kotoole1/LooneyTunes/README.md

Pitches
=======
(ain't shit)

POE Project repository
