kotoole1/LooneyTunes/DocumentationWebsite/static/PDFs/CriticalDesignReview.pdf

# Looney Tunes

Preliminary Review
Allie, Chris, Kevin, Kyle, Philicia

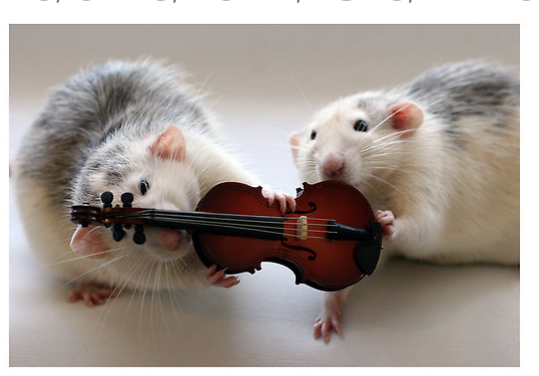
[picture p1: figure]

Things we’ve done...

- Transition from 1 string to 4 strings
- Addition of a bow wheel
- Addition of “string pulling” system
- Addition of an amplifier
- Human interaction via Beagle Bone

### Mechanical Design Changes

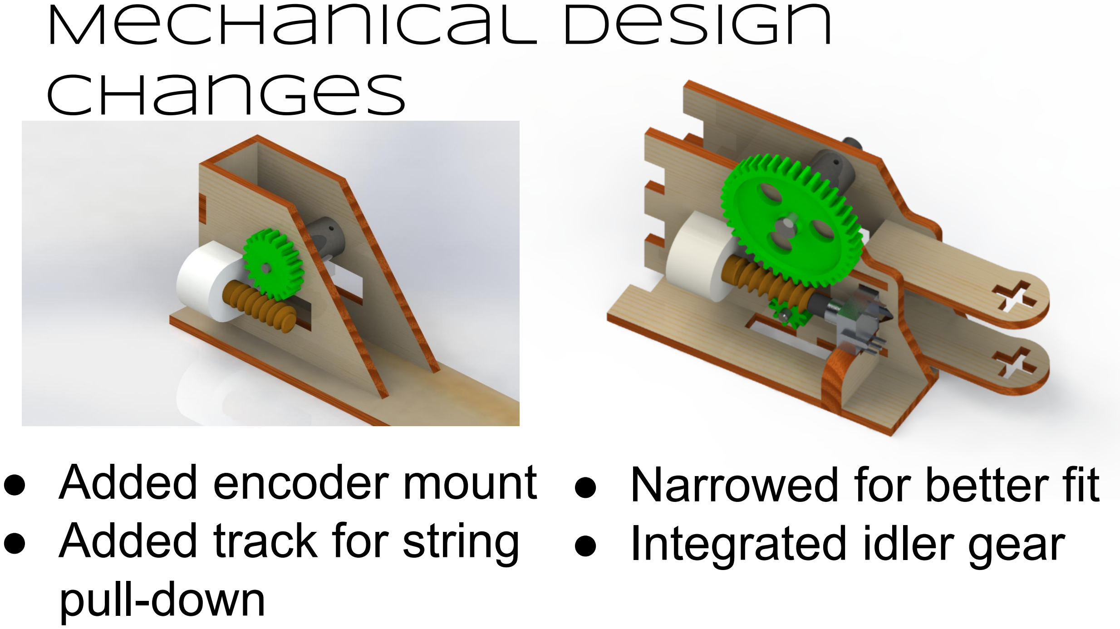
[picture p2: page 3]

- Added encoder mount
- Added track for string
pull-down
- Narrowed for better fit
- Integrated idler gear

### Electrical Design

- Integrated pickup
- Added filter to kill 60Hz noise
- Integrated H-Bridge motor control

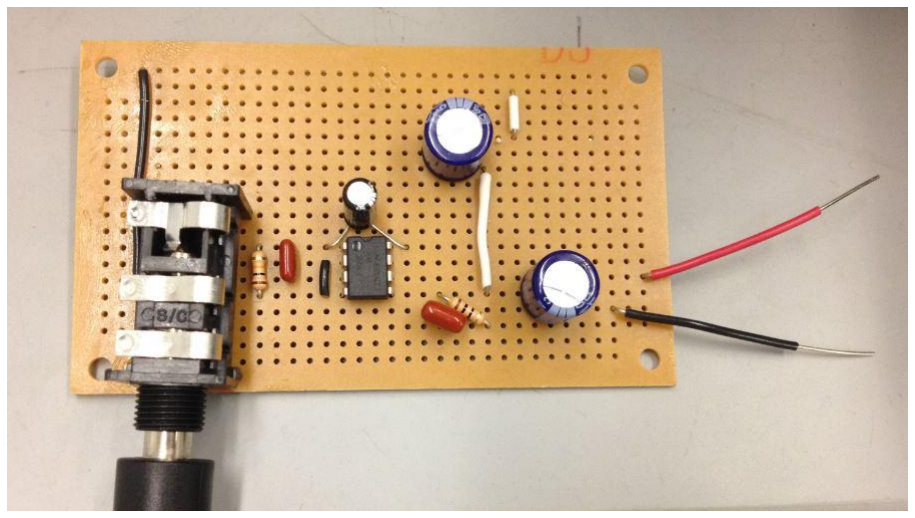
[picture p3: figure]

### Software Design

- Got Beagle Bone working!

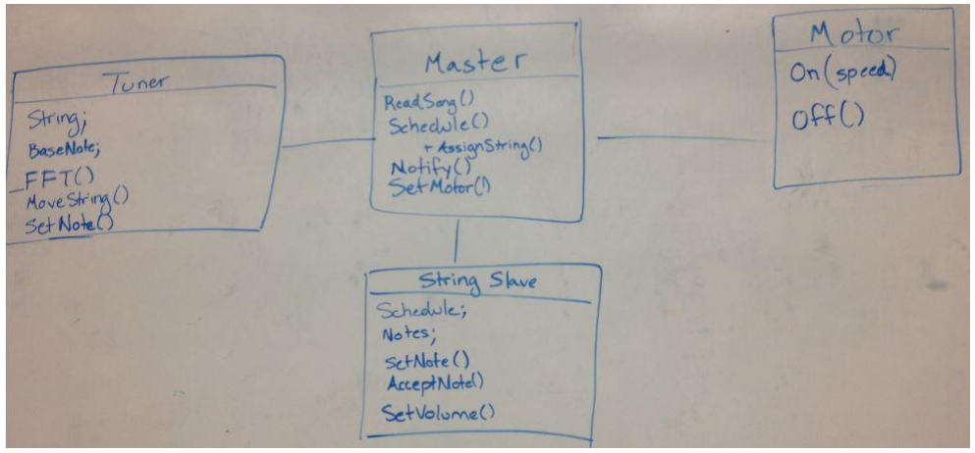
[picture p4: figure]

### Things to work on…

- Stiffness of bridge and far panel
- Rollers for “string pulling” system
- Attachment of bow hair
- Bow’s motor
- Making it pretty!

# Questions?

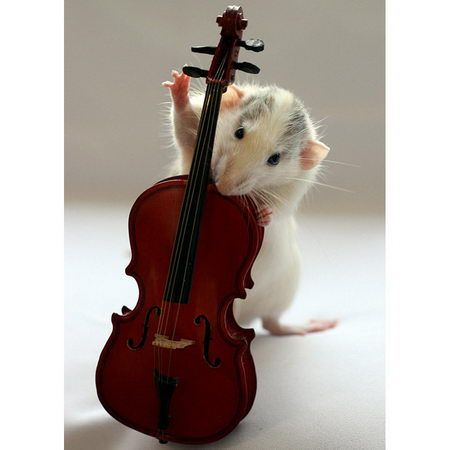
[picture p5: figure]
