kotoole1/LooneyTunes/DocumentationWebsite/static/PDFs/PreliminaryReviewPowerPoint.pdf

# Looney Tunes

# Preliminary Review

## Allie, Chris, Kevin, Kyle, Philicia

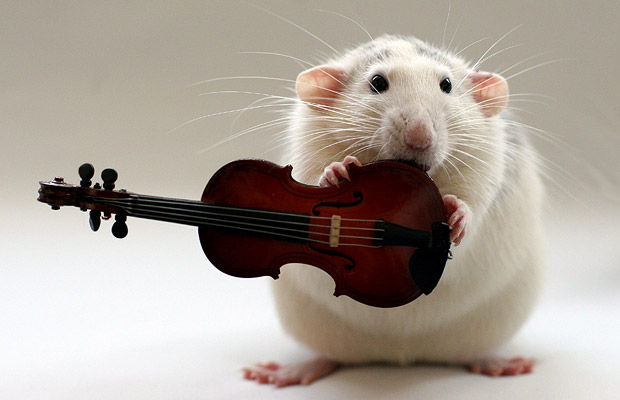
[picture p6: figure]

# Goals & Design Metrics

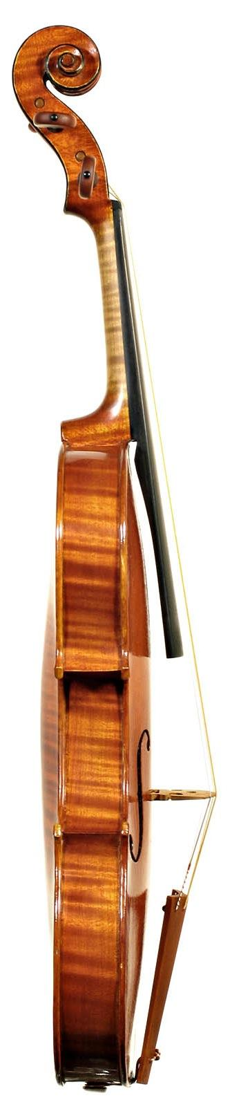
[picture p7: figure]

# 1. Create a string instrument that is controlled and played mechanically 2. Capable of playing music that a traditional violin cannot (e.g. chords, large interval

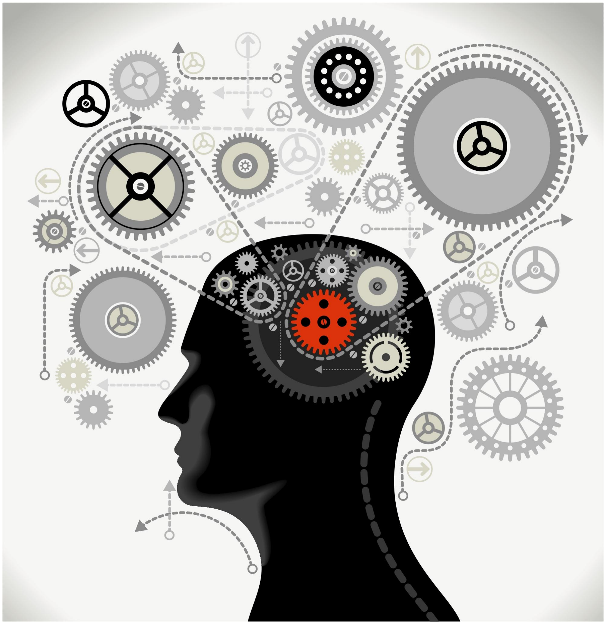
[picture p8: figure]

# gaps) 3. Connect to an engaging interface for the listener to choose songs

# System Diagram

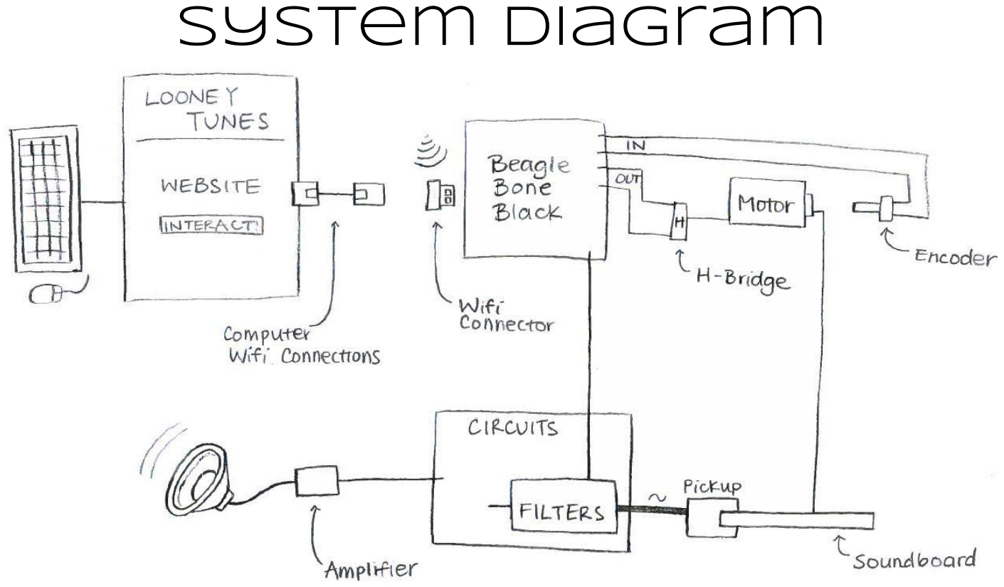
[picture p9: page 3]

# Rough mechanical design

# Block CAD

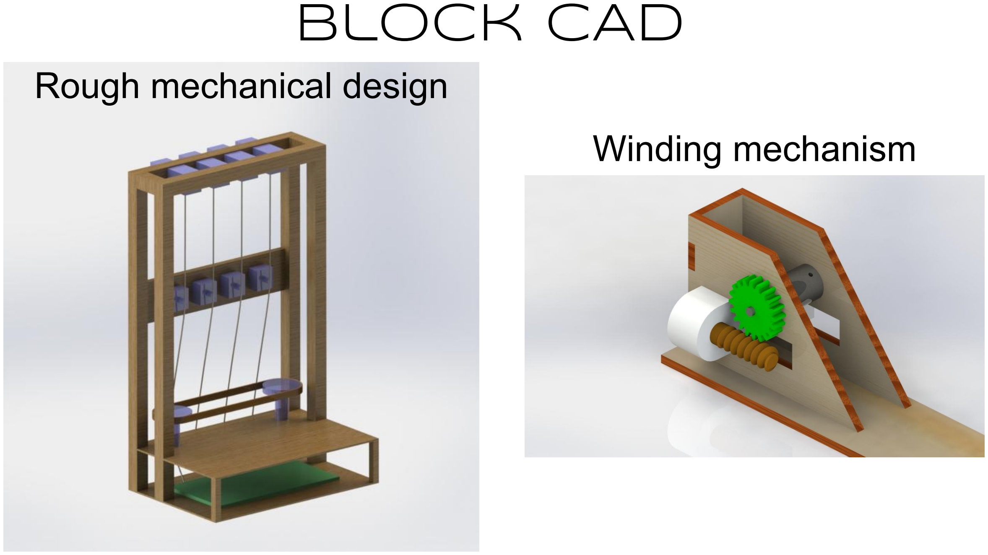
[picture p10: page 4]

# Winding mechanism

# Electrical Subsystem

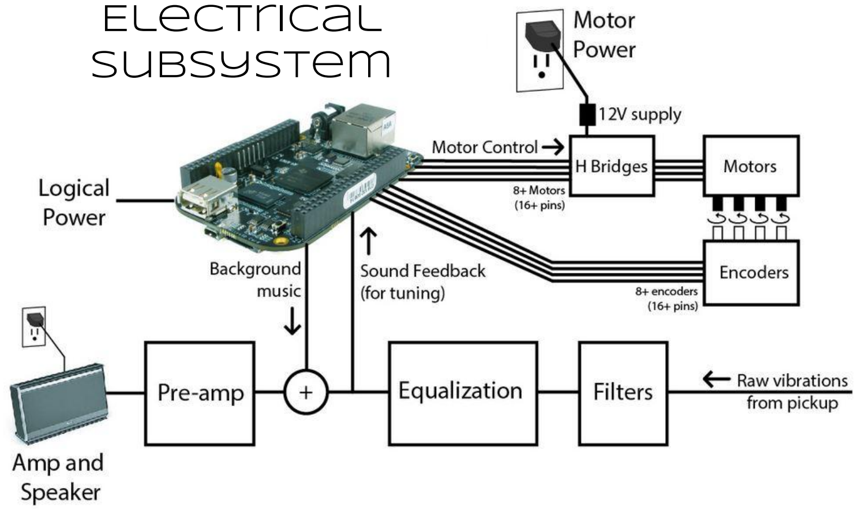
[picture p11: page 5]

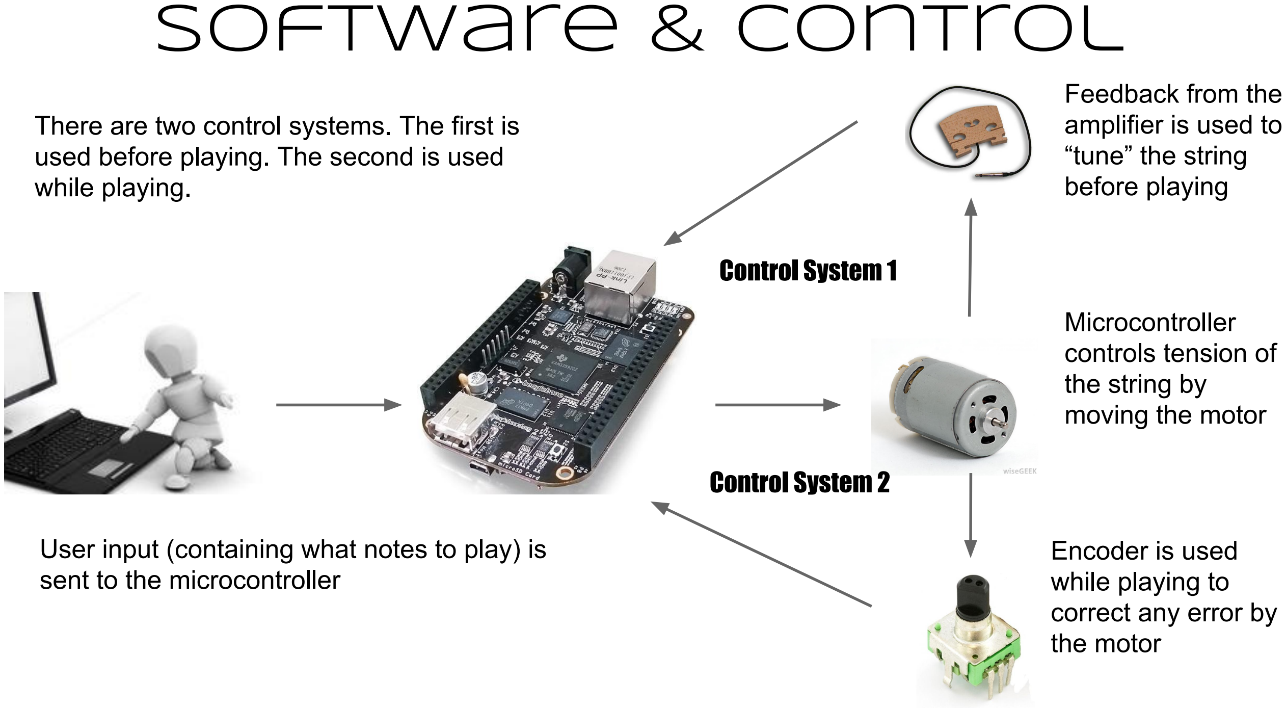
[picture p12: figure]
Software & Control; Microcontroller controls tension of the string by moving the motor; Feedback from the amplifier is used to “tune” the string before playing; Encoder is used while playing to correct any error by the motor; sent to the microcontroller; Control System 1; Control System 2; used before playing. The second is used while playing.

User input (containing what notes to play) is

There are two control systems. The first is

# Critical Milestones & Deadlines

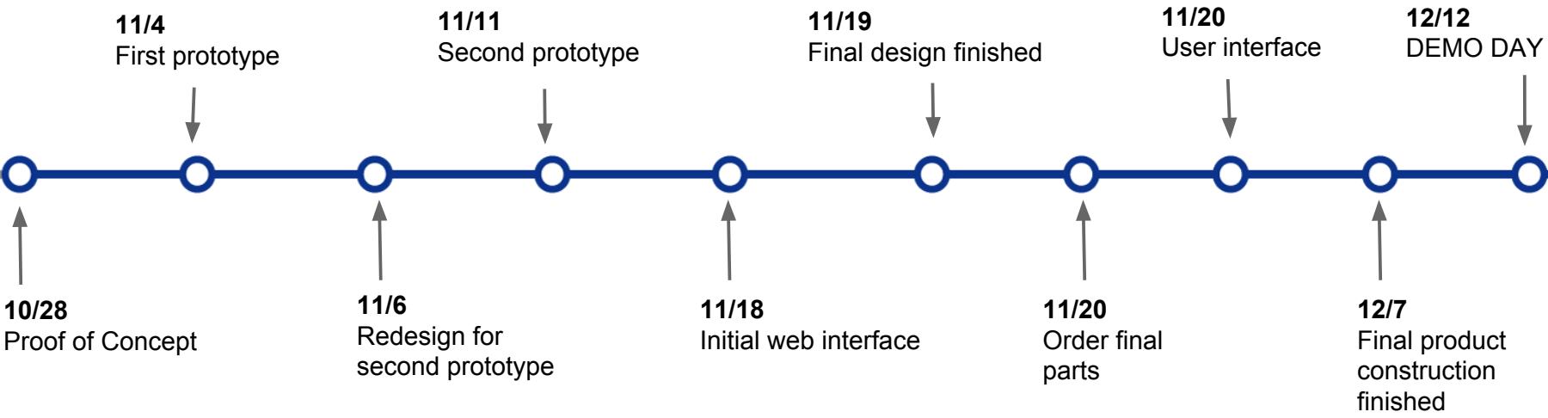
[picture p13: figure]
10/28 Proof of Concept; 11/4 First prototype; 11/6 Redesign for second prototype; 11/11 Second prototype; 11/18 Initial web interface; 11/20 Order final parts; 12/12 DEMO DAY; 12/7 Final product construction finished; 11/19 Final design finished; 11/20 User interface

# Proof of concept

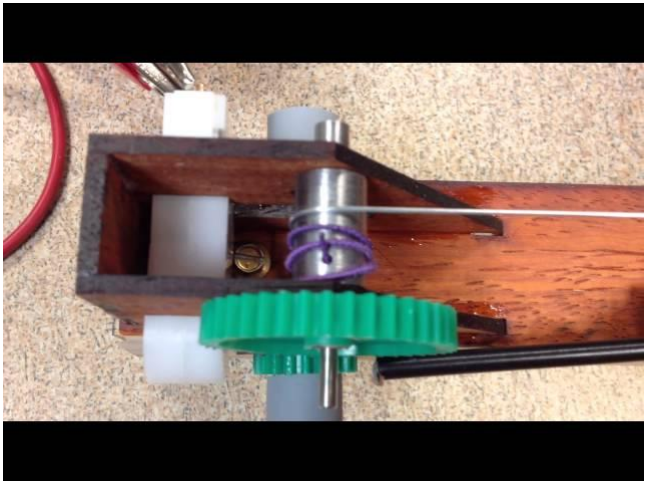
[picture p14: figure]

# Proof of Concept

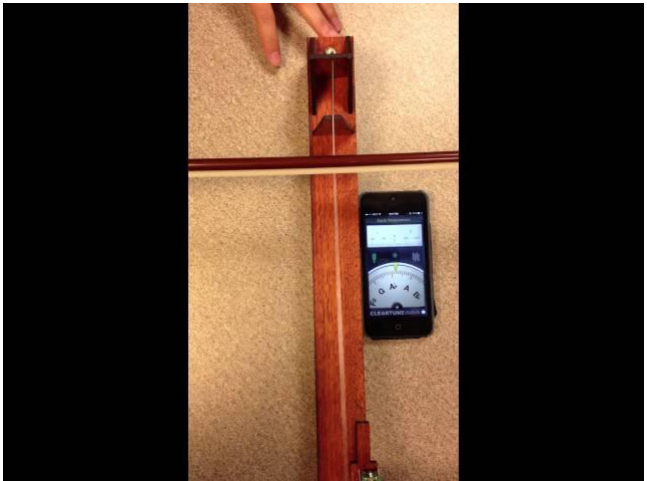
[picture p15: figure]

# Questions?

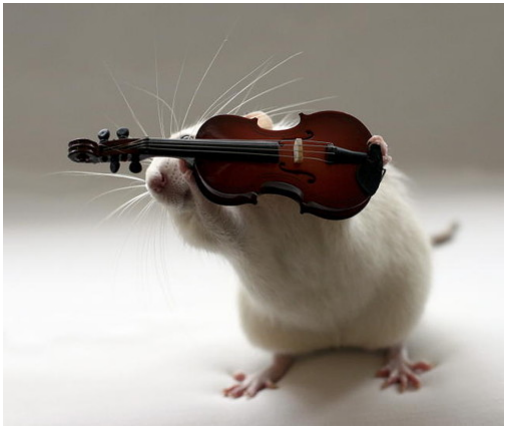
[picture p16: figure]
