kotoole1/LooneyTunes/DocumentationWebsite/static/PDFs/LT3-schematic.pdf

# Electrical Overview

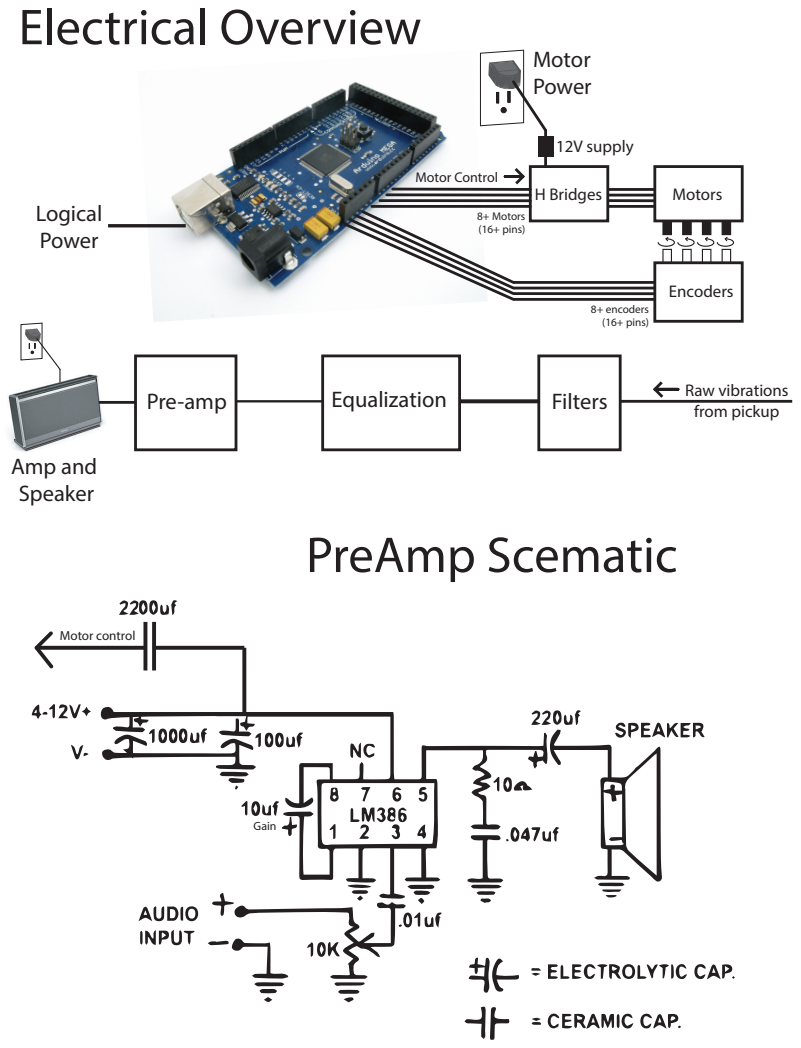
[picture p17: page 1]
Pre-amp; Filters; Amp and Speaker; Raw vibrations; Logical Power; H Bridges; Motor Power; 12V supply; Motors; Encoders; Motor Control; 8+ Motors (16+ pins); 8+ encoders (16+ pins); Gain; Motor control; PreAmp Scematic

from pickup Equalization

5V Logical Power

12V Motor Power | 5V (EN HIGH)

5V (EN HIGH)

L293D

Motor 1
INPUT 1

Motor 2
INPUT 2

Motor 1
INPUT 2

Motor 2
INPUT 1

GND

GND | GND
| GND

Motor 1
OUTPUT HIGH

Motor 1
OUTPUT LOW | Motor 2
| OUTPUT LOW

Motor 2
Output HIGH

# H-Bridge Connections
