kotoole1/LooneyTunes/DocumentationWebsite/static/PDFs/LT3-DrawingPackage.pdf

12 | 7 | 23 | 9 | 10 | 8 | 13 | 6 | 24 | 11

1

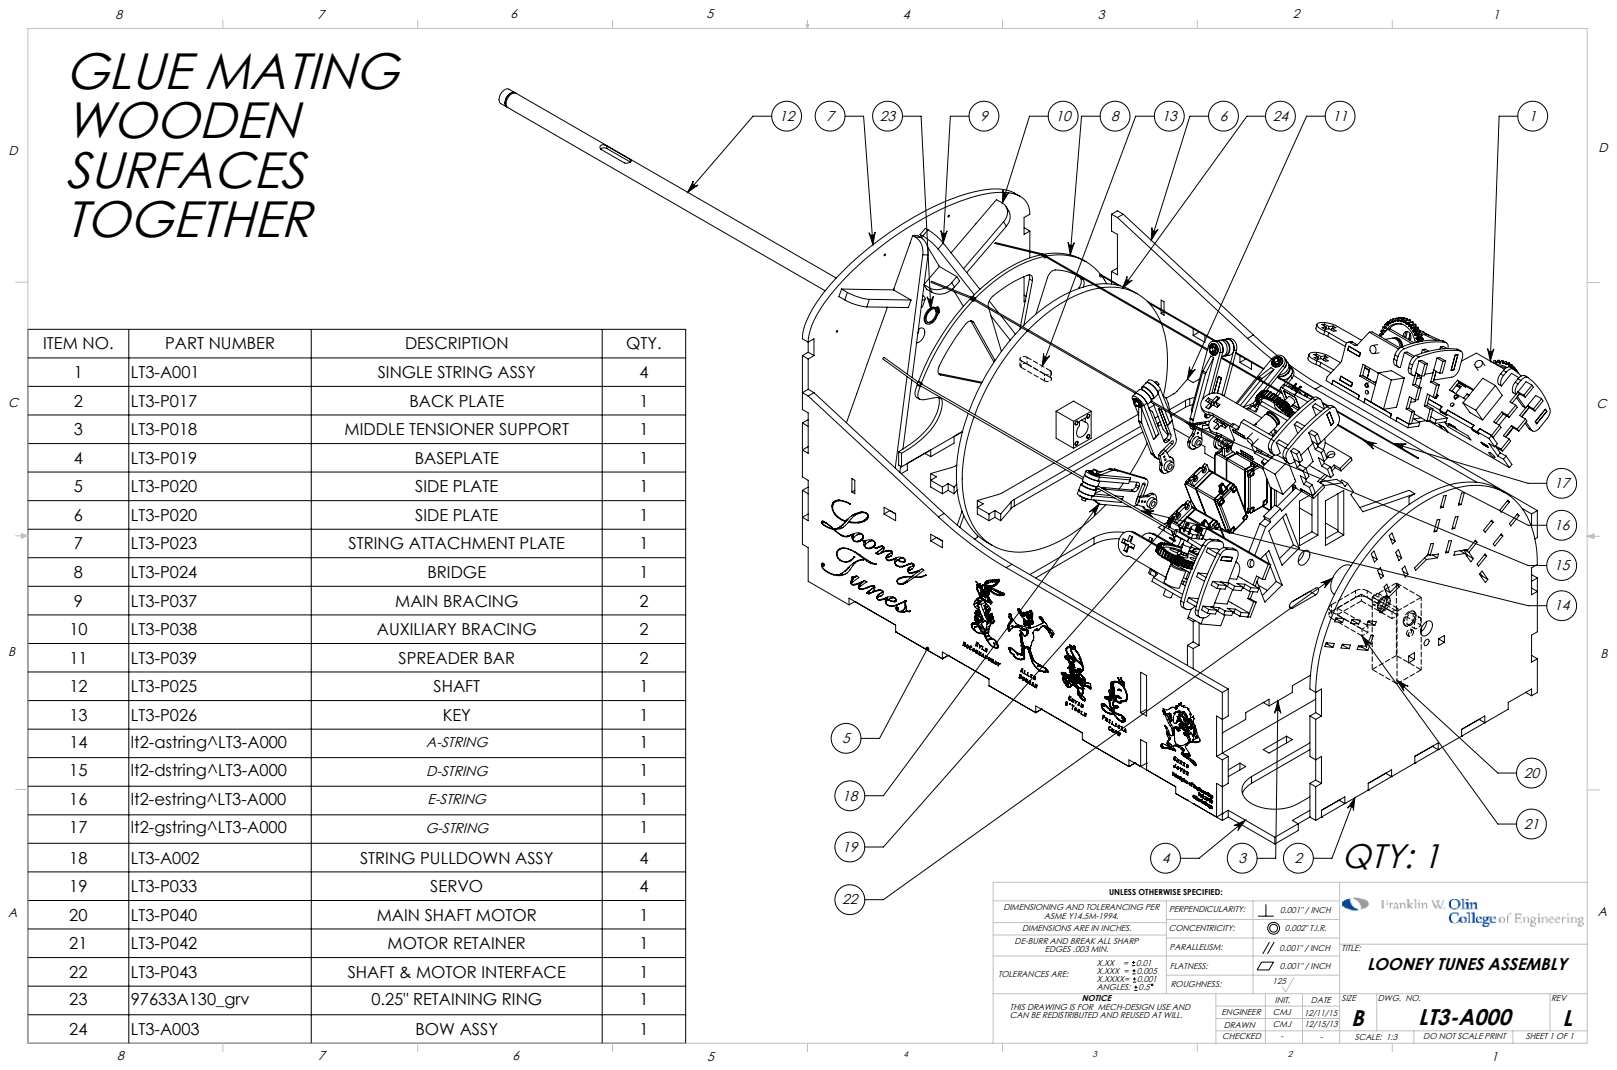
[picture p18: page 1]
GLUE MATING WOODEN SURFACES TOGETHER; QTY: 1

ITEM NO. | PART NUMBER | DESCRIPTION | QTY.
1 | LT3-A001 | SINGLE STRING ASSY | 4
2 | LT3-P017 | BACK PLATE | 1
3 | LT3-P018 | MIDDLE TENSIONER SUPPORT | 1
4 | LT3-P019 | BASEPLATE | 1
5 | LT3-P020 | SIDE PLATE | 1
6 | LT3-P020 | SIDE PLATE | 1
7 | LT3-P023 | STRING ATTACHMENT PLATE | 1
8 | LT3-P024 | BRIDGE | 1
9 | LT3-P037 | MAIN BRACING | 2
10 | LT3-P038 | AUXILIARY BRACING | 2
11 | LT3-P039 | SPREADER BAR | 2
12 | LT3-P025 | SHAFT | 1
13 | LT3-P026 | KEY | 1
14 | lt2-astring^LT3-A000 | A-STRING | 1
15 | lt2-dstring^LT3-A000 | D-STRING | 1
16 | lt2-estring^LT3-A000 | E-STRING | 1
17 | lt2-gstring^LT3-A000 | G-STRING | 1
18 | LT3-A002 | STRING PULLDOWN ASSY | 4
19 | LT3-P033 | SERVO | 4
20 | LT3-P040 | MAIN SHAFT MOTOR | 1
21 | LT3-P042 | MOTOR RETAINER | 1
22 | LT3-P043 | SHAFT & MOTOR INTERFACE | 1
23 | 97633A130_grv | 0.25" RETAINING RING | 1
24 | LT3-A003 | BOW ASSY | 1

UNLESS OTHERWISE SPECIFIED: DIMENSIONING AND TOLERANCING PER PERPENDICULARITY: 0.001" / INCH ASME Y14.5M-1994. DIMENSIONS ARE IN INCHES. CONCENTRICITY: 0.002" T.I.R. DE-BURR AND BREAK ALL SHARP EDGES .003 MIN. PARALLELISM: 0.001" / INCH X.XX = 0.01 FLATNESS: 0.001" / INCH TOLERANCES ARE: X.XXX = 0.005 X.XXXX= 0.001 125 ROUGHNESS: ANGLES: 0.5

TITLE:
LOONEY TUNES ASSEMBLY

NOTICE THIS DRAWING IS FOR MECH-DESIGN USE AND CAN BE REDISTRIBUTED AND REUSED AT WILL. | INIT. DATE 12/15/13 ENGINEER CMJ 12/11/15 DRAWN CMJ CHECKED - | SIZE B | DWG. NO. LT3-A000 | REV L -

SCALE: 1:3 | DO NOT SCALE PRINT | SHEET 1 OF 1

14 | 7
ITEM NO. | PART NUMBER | DESCRIPTION | QTY.

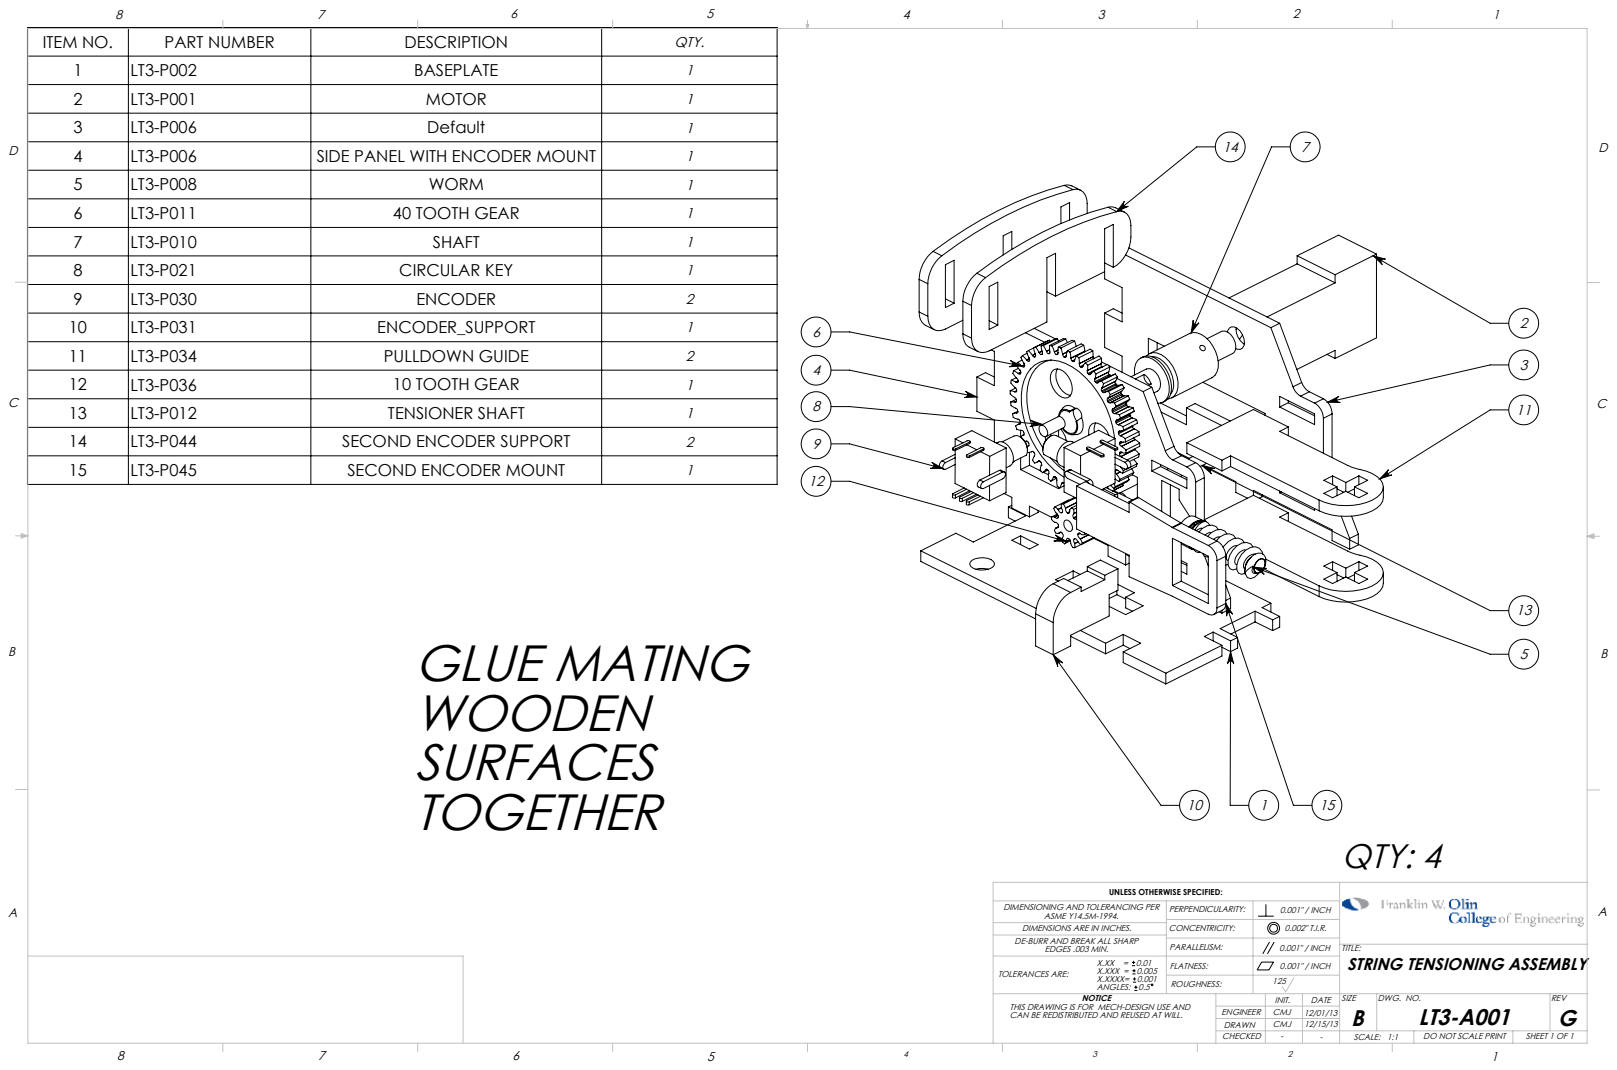
[picture p19: page 2]
GLUE MATING WOODEN SURFACES TOGETHER; QTY: 4

1 | LT3-P002 | BASEPLATE | 1
2 | LT3-P001 | MOTOR | 1
3 | LT3-P006 | Default | 1
4 | LT3-P006 | SIDE PANEL WITH ENCODER MOUNT | 1
5 | LT3-P008 | WORM | 1
6 | LT3-P011 | 40 TOOTH GEAR | 1
7 | LT3-P010 | SHAFT | 1
8 | LT3-P021 | CIRCULAR KEY | 1
9 | LT3-P030 | ENCODER | 2
10 | LT3-P031 | ENCODER_SUPPORT | 1
11 | LT3-P034 | PULLDOWN GUIDE | 2
12 | LT3-P036 | 10 TOOTH GEAR | 1
13 | LT3-P012 | TENSIONER SHAFT | 1
14 | LT3-P044 | SECOND ENCODER SUPPORT | 2
15 | LT3-P045 | SECOND ENCODER MOUNT | 1

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

TITLE:
STRING TENSIONING ASSEMBLY

12/15/13 CMJ 12/01/13 | | LT3-A001 | G -

SCALE: 1:1 | | SHEET 1 OF 1

1

ITEM NO. | PART NUMBER | DESCRIPTION | QTY.

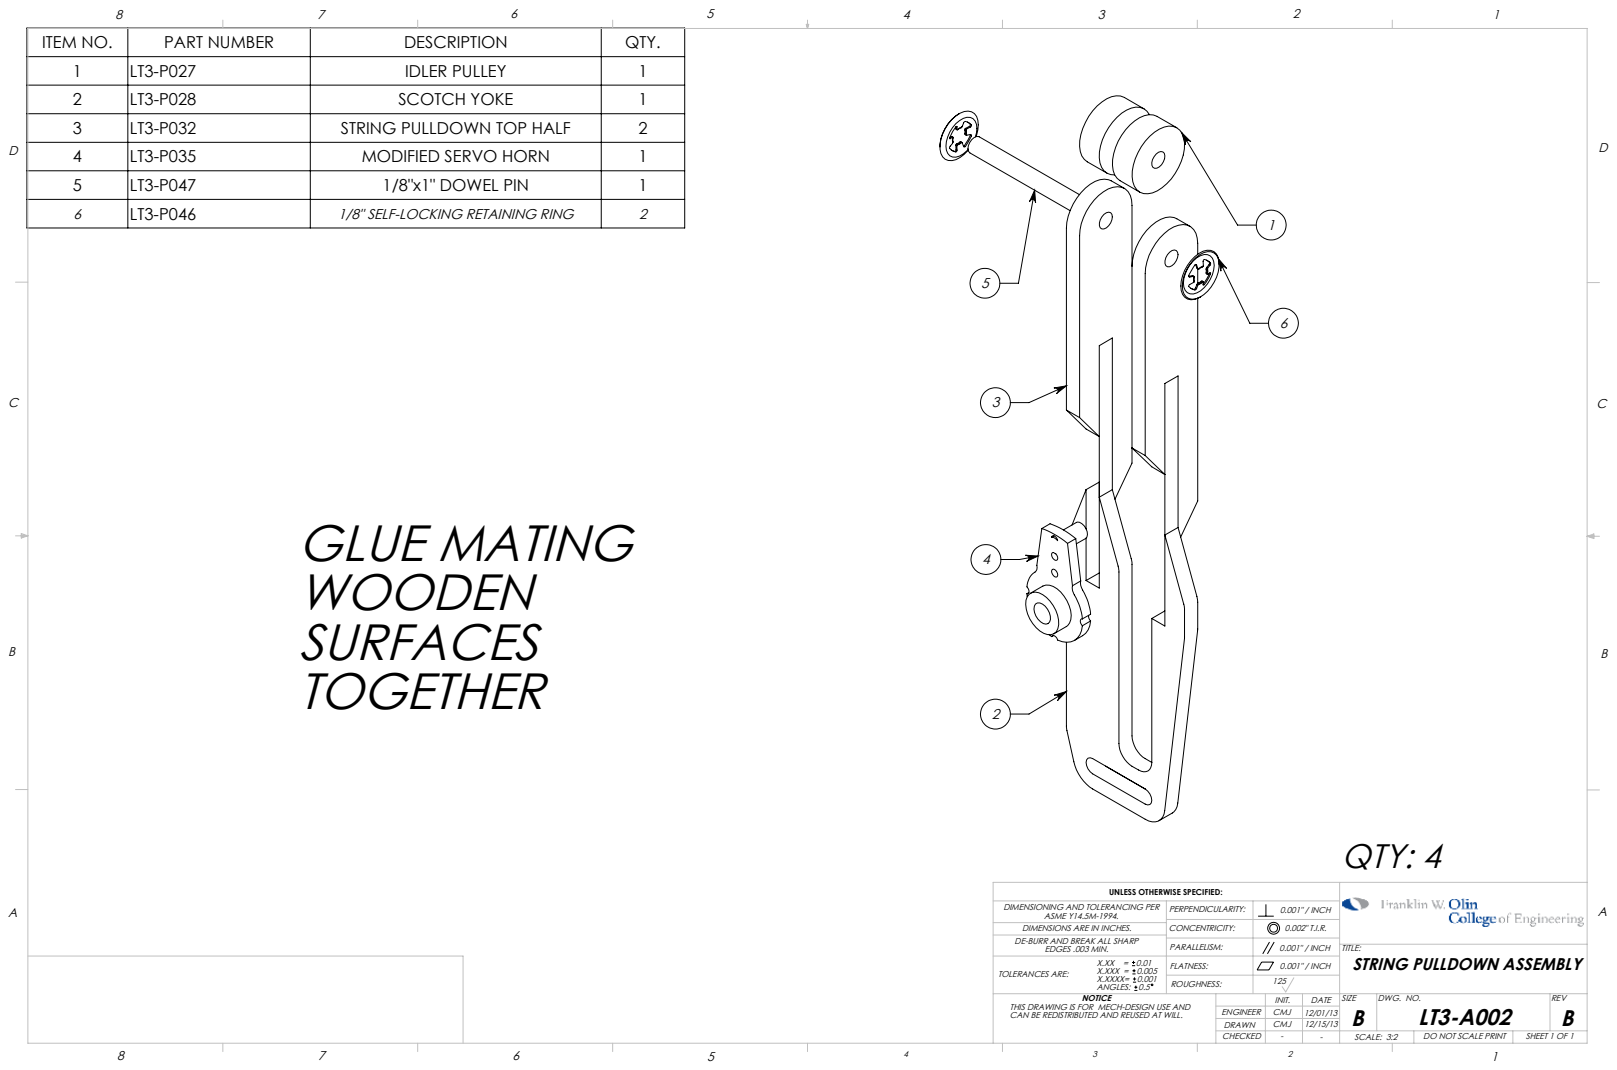
[picture p20: page 3]
GLUE MATING WOODEN SURFACES TOGETHER; QTY: 4

1 | LT3-P027 | IDLER PULLEY | 1
2 | LT3-P028 | SCOTCH YOKE | 1
3 | LT3-P032 | STRING PULLDOWN TOP HALF | 2
4 | LT3-P035 | MODIFIED SERVO HORN | 1
5 | LT3-P047 | 1/8"x1" DOWEL PIN | 1
6 | LT3-P046 | 1/8" SELF-LOCKING RETAINING RING | 2

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

TITLE:
STRING PULLDOWN ASSEMBLY

12/15/13 CMJ 12/01/13 | | LT3-A002 | B -

SCALE: 3:2 | | SHEET 1 OF 1

1

ITEM NO. | PART NUMBER | DESCRIPTION | QTY.

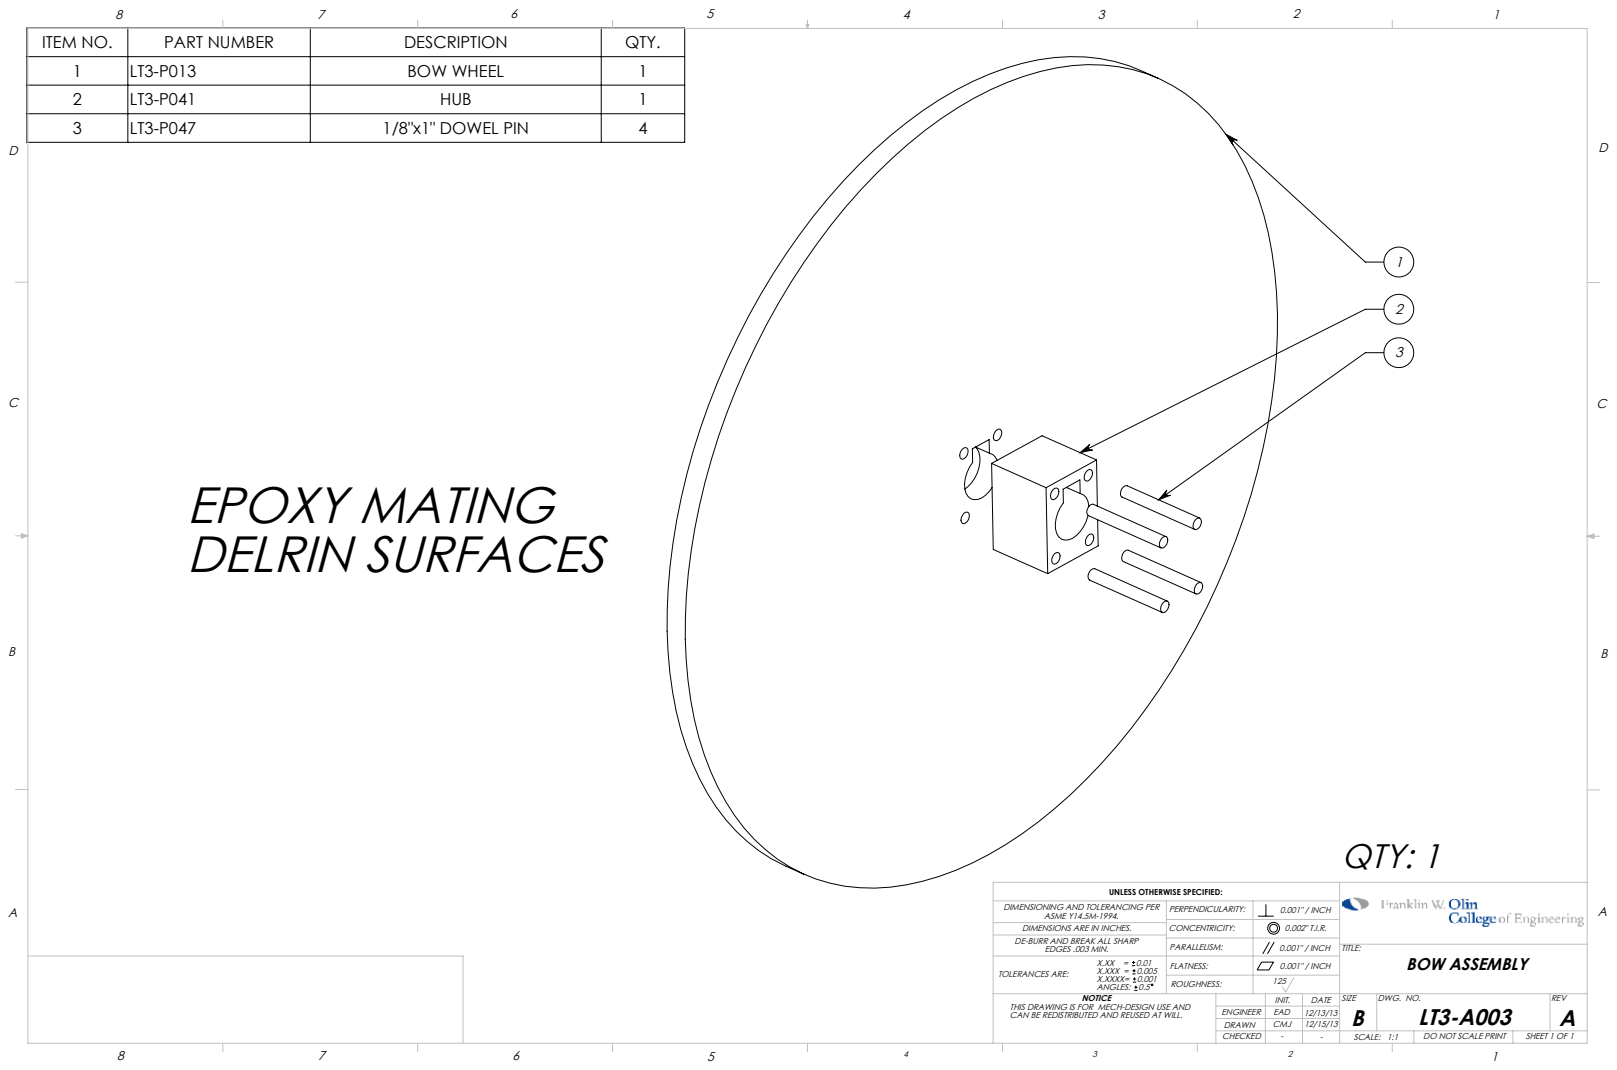
[picture p21: page 4]
EPOXY MATING DELRIN SURFACES; TITLE:; BOW ASSEMBLY; QTY: 1

1 | LT3-P013 | BOW WHEEL | 1
2 | LT3-P041 | HUB | 1
3 | LT3-P047 | 1/8"x1" DOWEL PIN | 4

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

12/15/13 EAD 12/13/13 | | LT3-A003 | A -

SCALE: 1:1 | | SHEET 1 OF 1

.500 2X .250 | .438

D

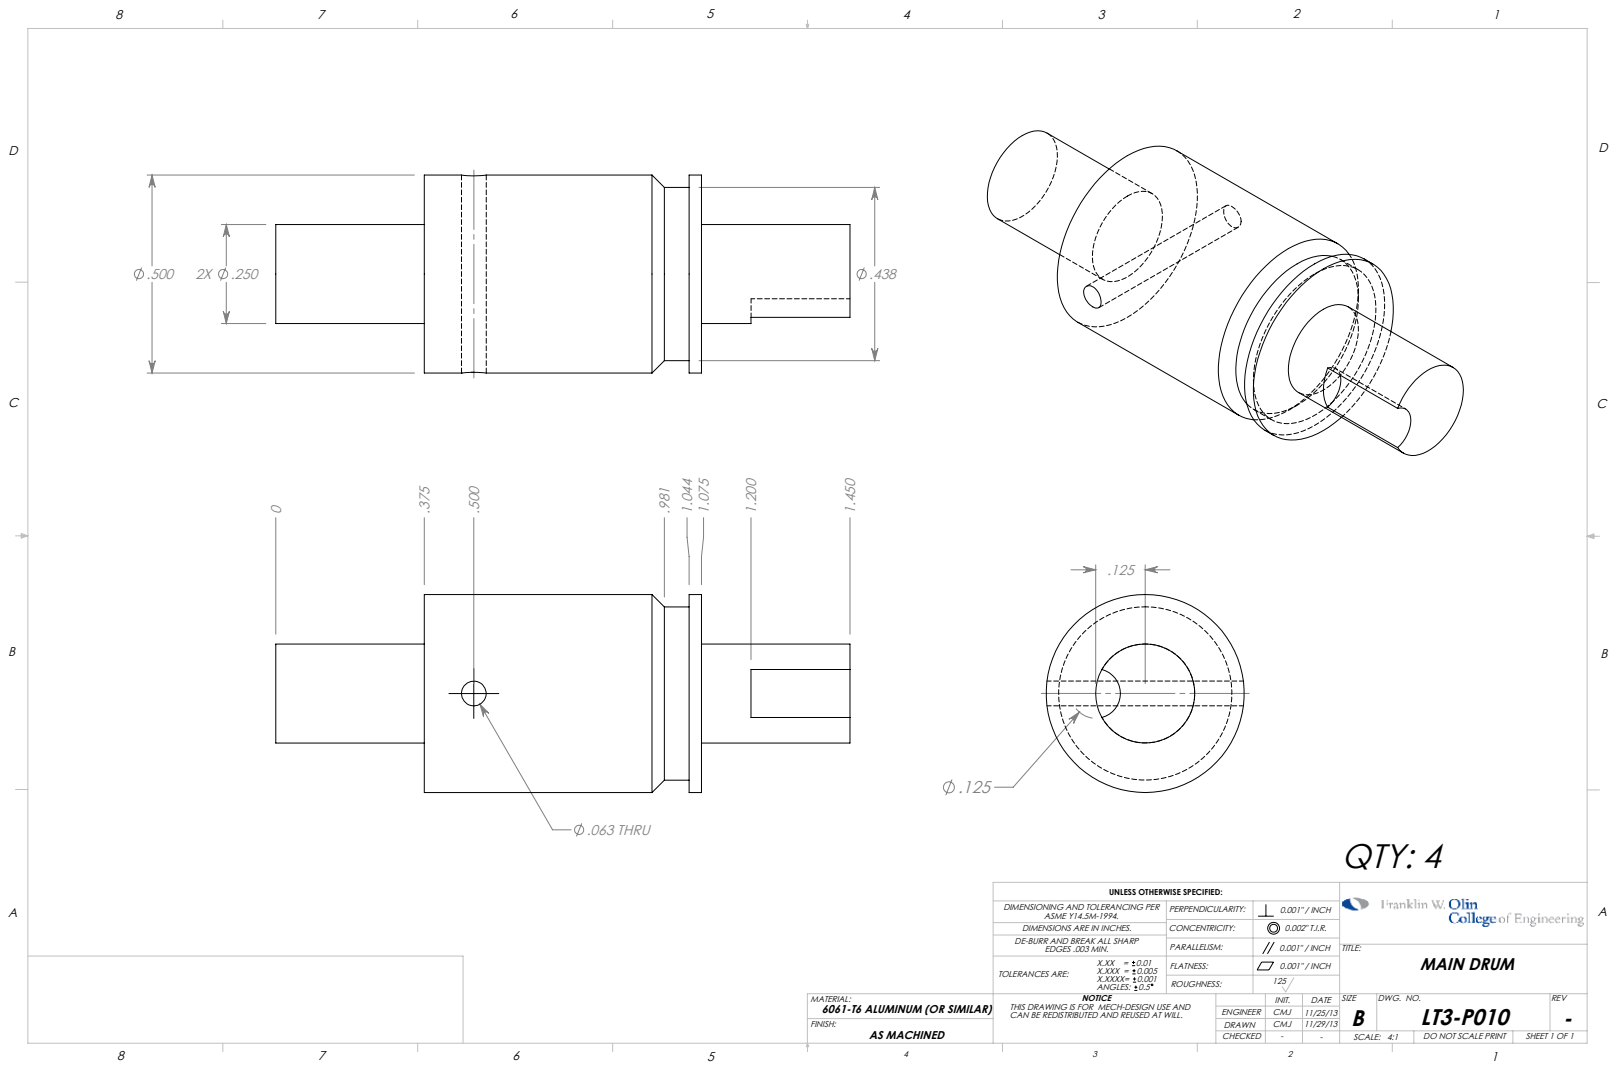
[picture p22: page 5]
.063 THRU; FINISH:; AS MACHINED; TITLE:; SCALE: 4:1; SHEET 1 OF 1; MAIN DRUM; QTY: 4

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

MATERIAL: 6061-T6 ALUMINUM (OR SIMILAR) | 11/29/13 CMJ 11/25/13 | LT3-P010 | - -

# 40T MODULE 1 GEAR BLANK

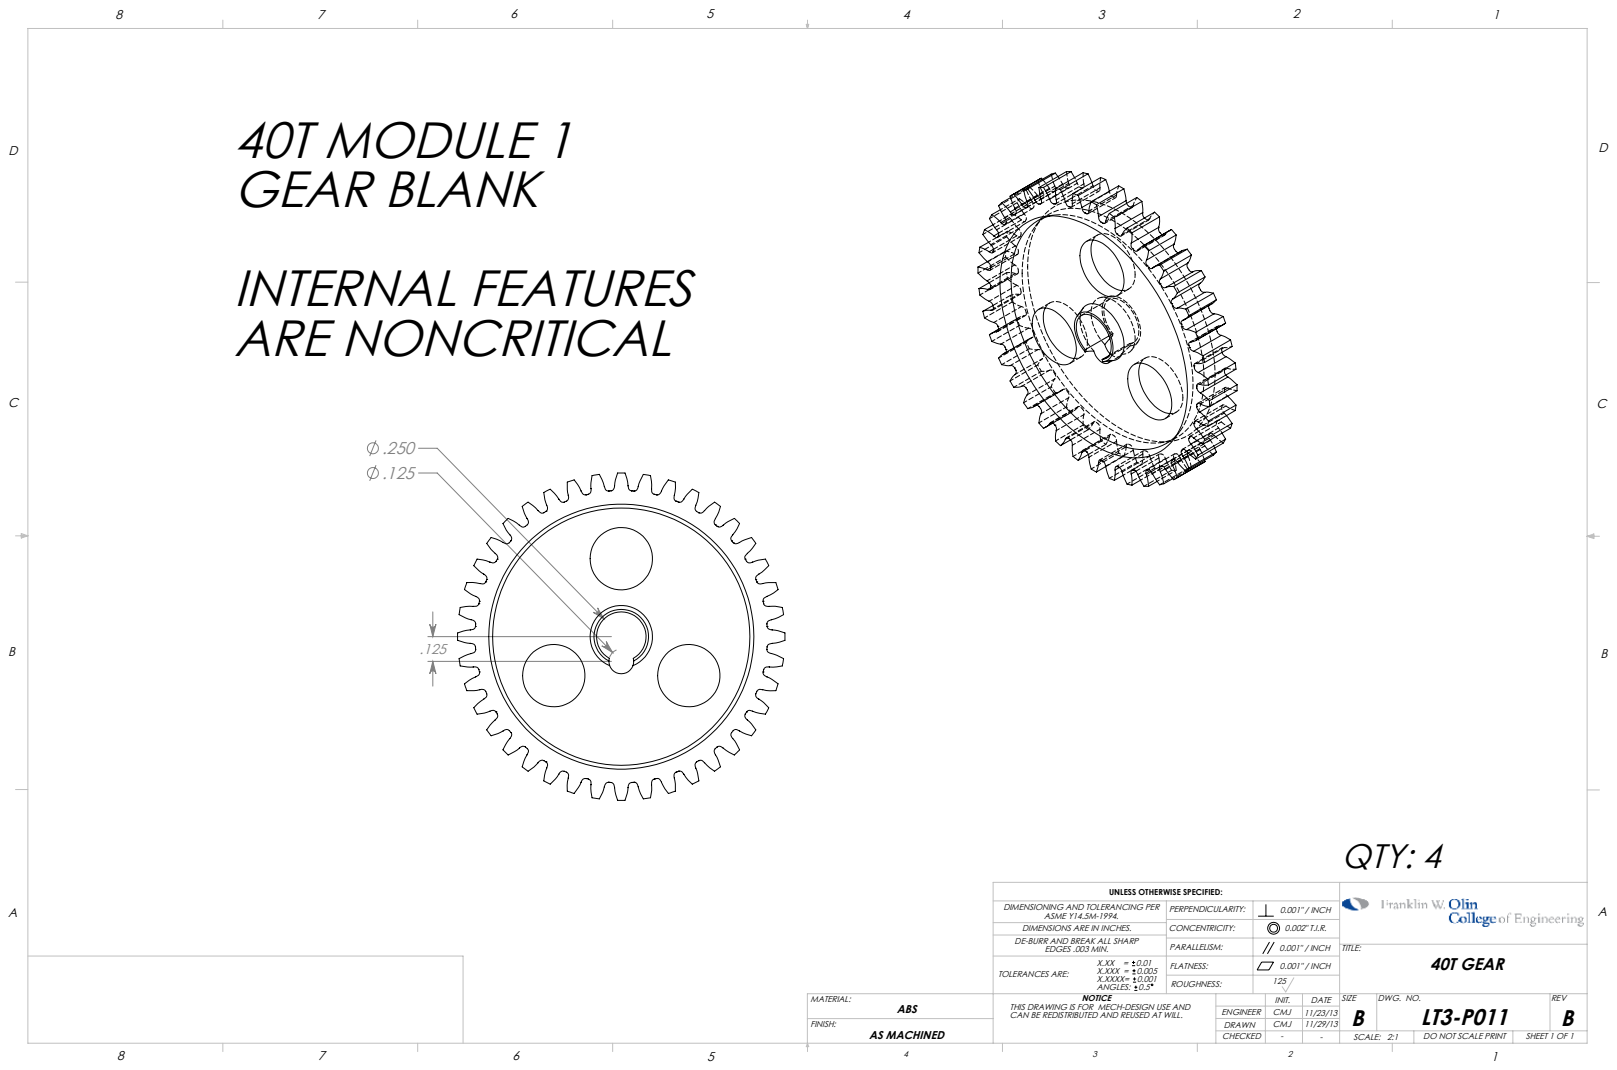
[picture p23: page 6]
INTERNAL FEATURES ARE NONCRITICAL; TITLE:; SCALE: 2:1; SHEET 1 OF 1; 40T GEAR; QTY: 4

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

ABS | CMJ 11/23/13 | B -

D
D

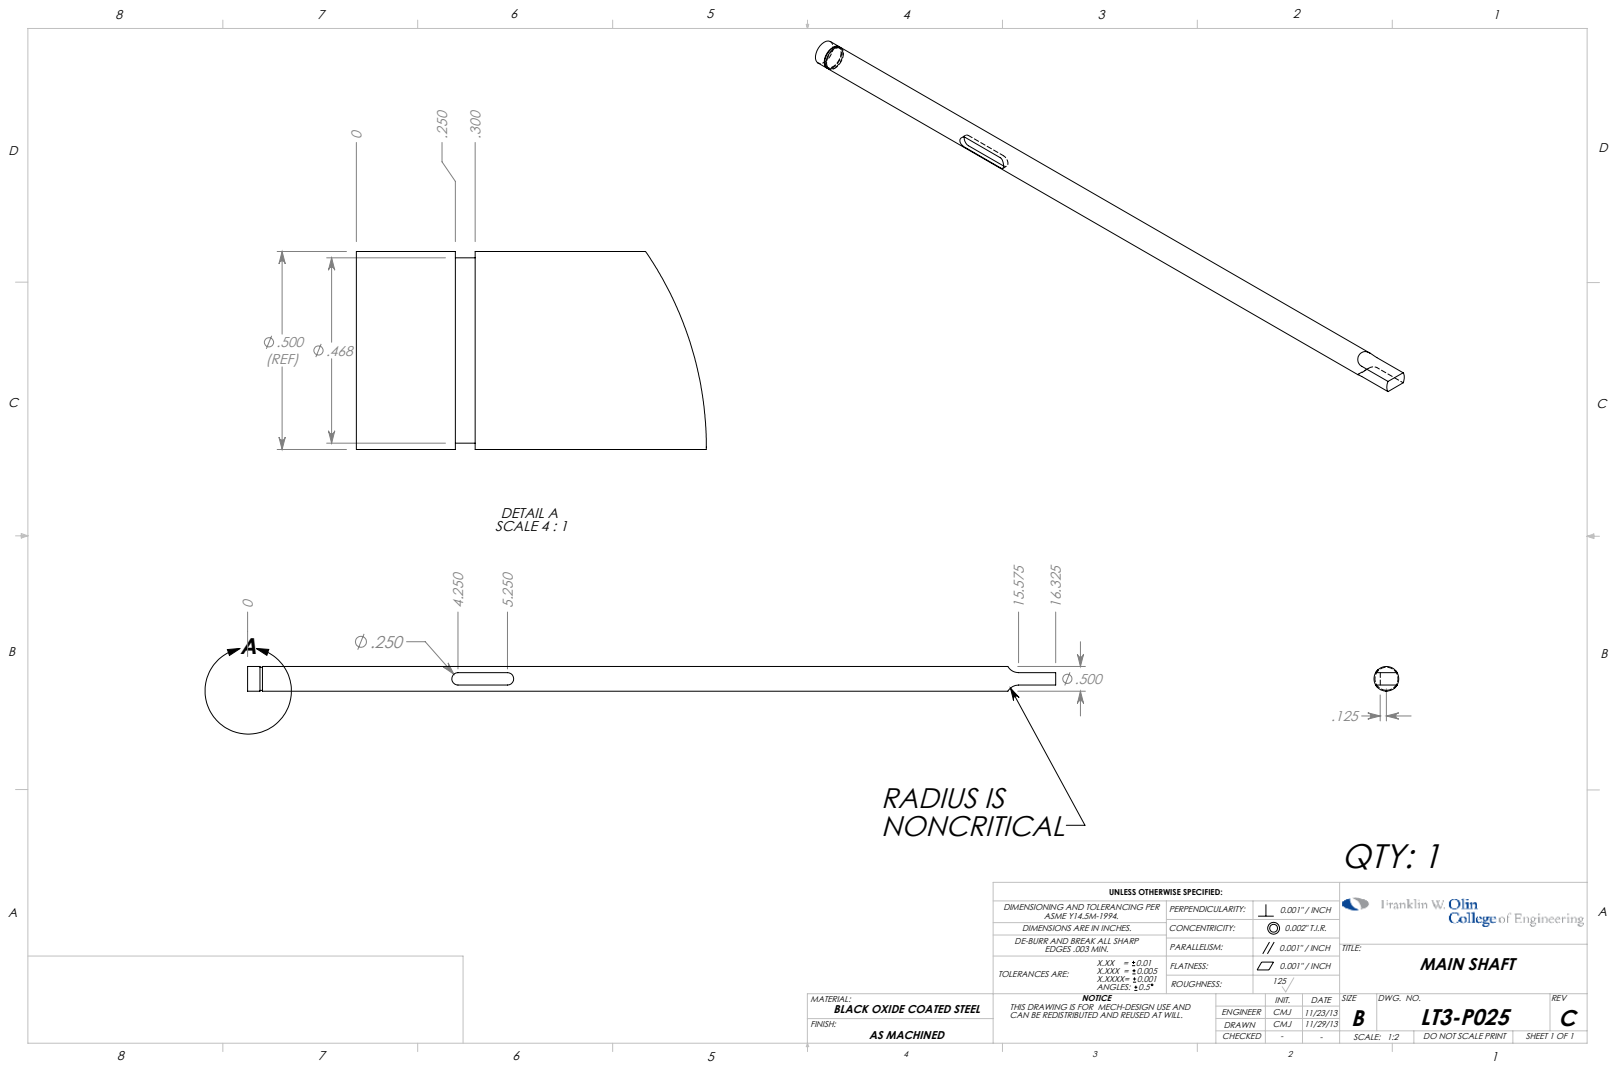
[picture p24: page 7]
RADIUS IS NONCRITICAL; .468 .500 (REF); DETAIL A SCALE 4 : 1; TITLE:; SCALE: 1:2; SHEET 1 OF 1; MAIN SHAFT; QTY: 1

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

BLACK OXIDE COATED STEEL | CMJ 11/23/13 | C -

D
D

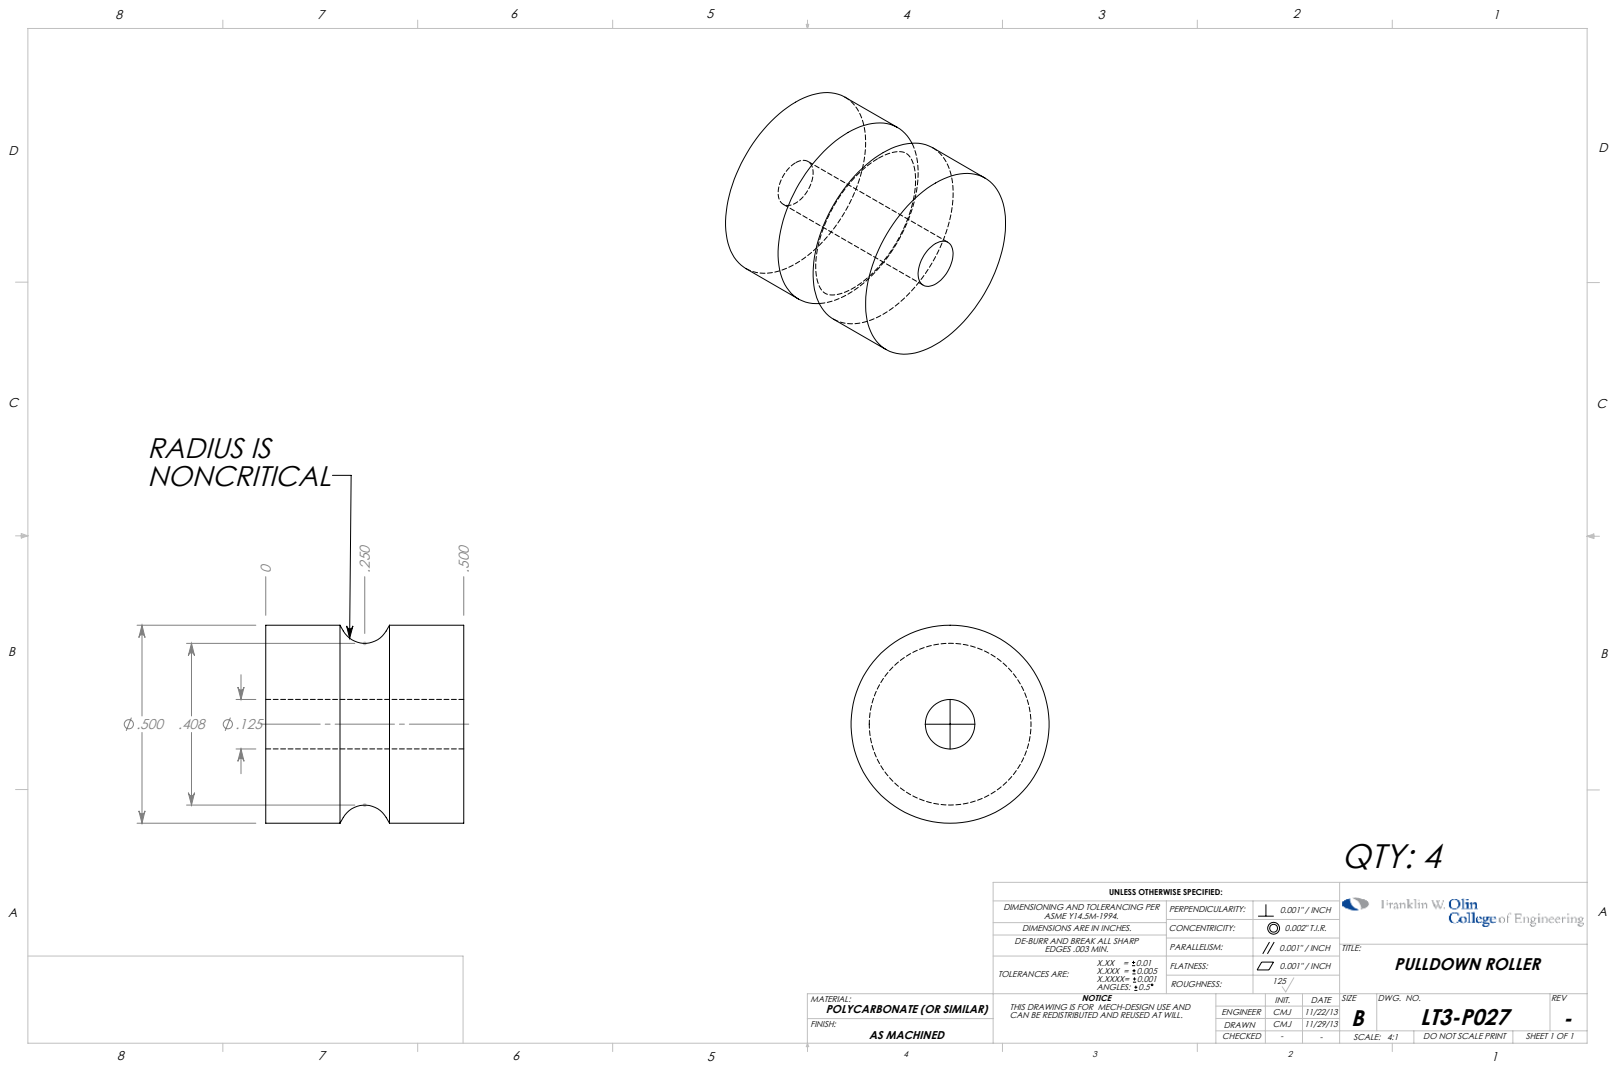
[picture p25: page 8]
RADIUS IS NONCRITICAL; TITLE:; SCALE: 4:1; SHEET 1 OF 1; PULLDOWN ROLLER; QTY: 4

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

POLYCARBONATE (OR SIMILAR) | CMJ 11/22/13 | - -

D
D

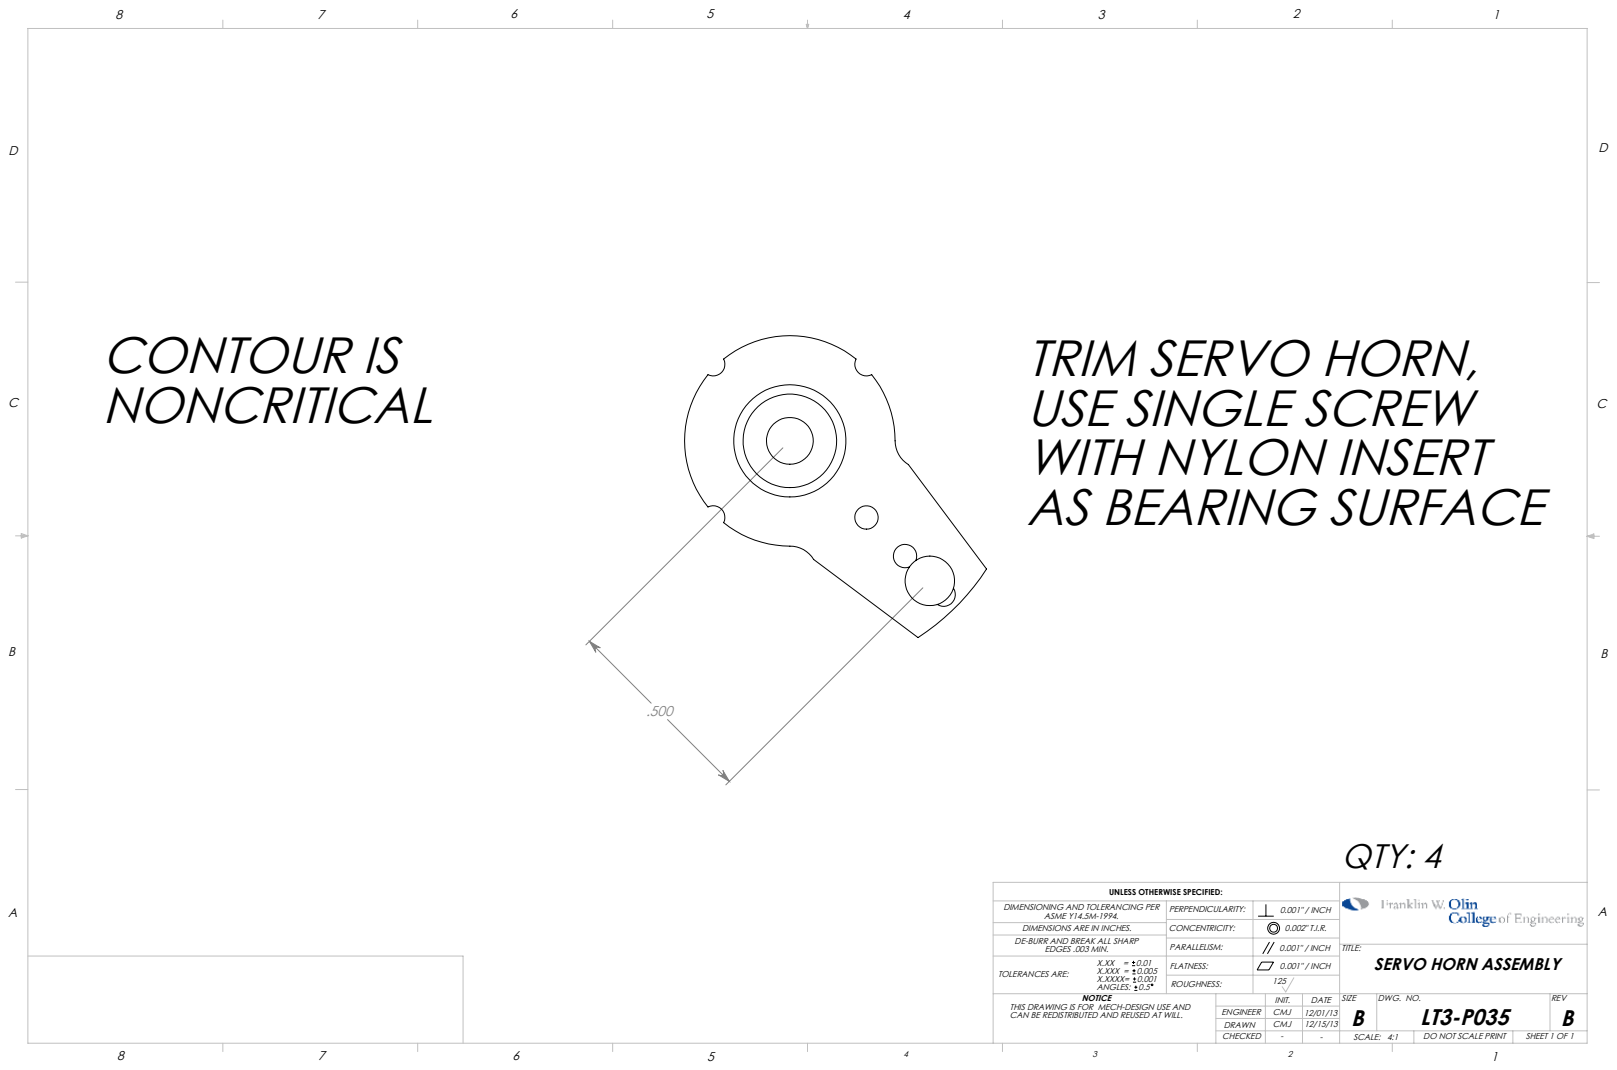
[picture p26: page 9]
CONTOUR IS NONCRITICAL; QTY: 4

TRIM SERVO HORN,
USE SINGLE SCREW
WITH NYLON INSERT
AS BEARING SURFACE

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

TITLE:
SERVO HORN ASSEMBLY

12/15/13 CMJ 12/01/13 | | LT3-P035 | B -

SCALE: 4:1 | | SHEET 1 OF 1

.750

D

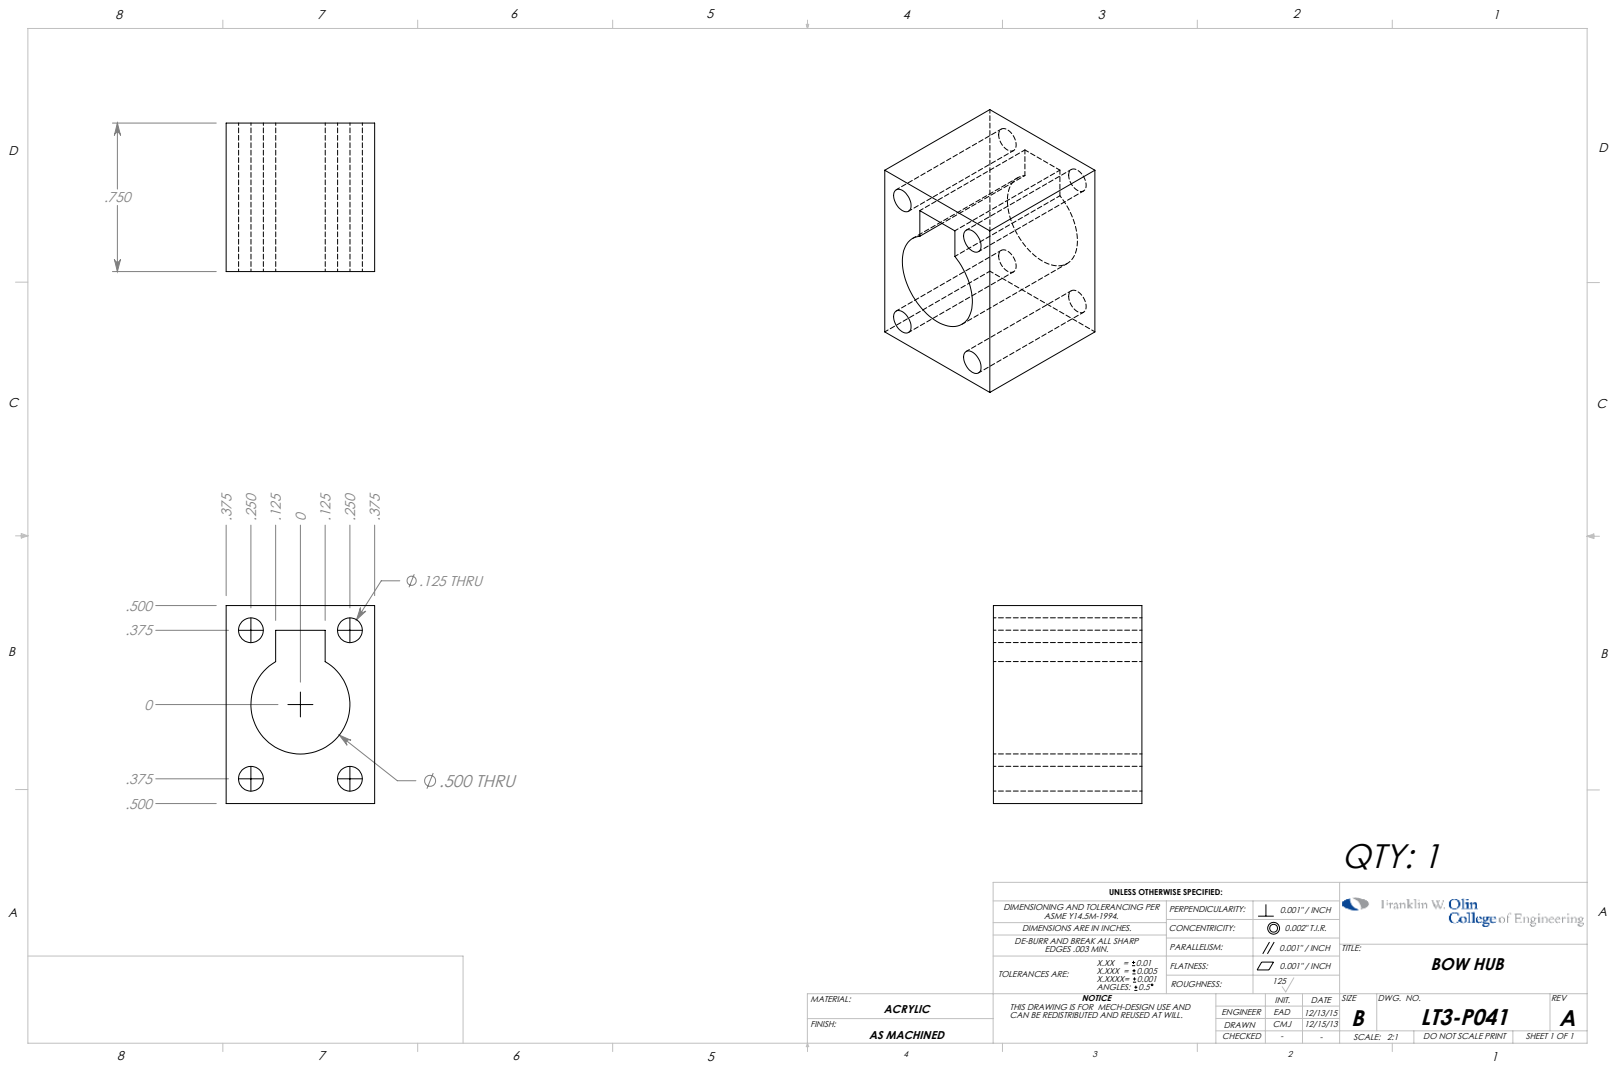
[picture p27: page 10]
.500 THRU; .125 THRU; TITLE:; SCALE: 2:1; SHEET 1 OF 1; BOW HUB; QTY: 1

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

ACRYLIC | 12/15/13 EAD 12/13/15 | LT3-P041 | A -

.250

1.000

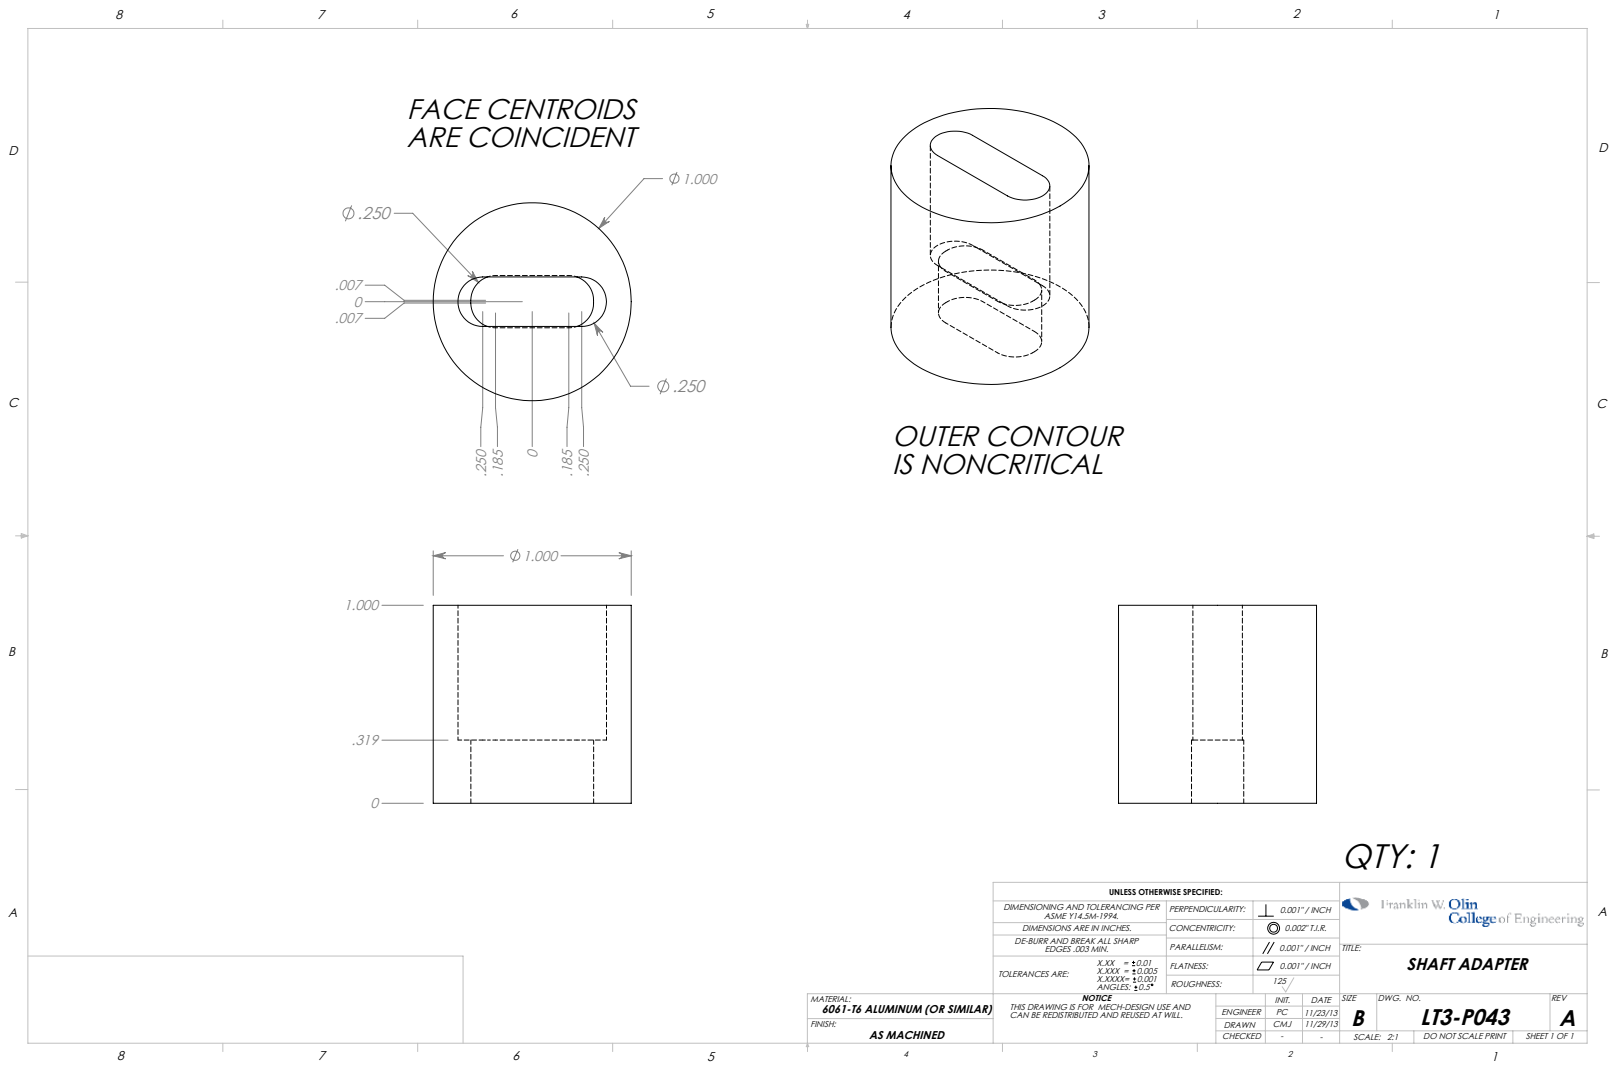
[picture p28: page 11]
FACE CENTROIDS ARE COINCIDENT; OUTER CONTOUR IS NONCRITICAL; TITLE:; SCALE: 2:1; SHEET 1 OF 1; SHAFT ADAPTER; QTY: 1

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

6061-T6 ALUMINUM (OR SIMILAR) | PC 11/23/13 | A -
