kotoole1/LooneyTunes/MotorControl/tuningBigEncoder/tuningBigEncoder.ino

/*
Tuning script used to tighten and loosen a string based on the "ticks" from the encoder
Values larger than 3 digits are truncated to 3 digits
Negetive values are supported
*/
#include <QuadEncoder.h>
#include <Servo.h>

const int BAUD_RATE = 9600;

//Servos
Servo servo1;
Servo servo2;
Servo servo3;
Servo servo4;

const int servo1pin = 2;
const int servo2pin = 3;
const int servo3pin = 4;
const int servo4pin = 5;

const int bow_motorpin1 = 22;
const int bow_motorpin2 = 24;

//String 1
//QuadEncoder encoder(37, 35);
//const int Motor1Pin1 = 52;
//const int Motor1Pin2 = 50;

//String 2
QuadEncoder encoder(33, 31);
const int Motor1Pin1 = 48;
const int Motor1Pin2 = 46;

//String 3
//QuadEncoder encoder(29, 27);
//const int Motor1Pin1 = 44;
//const int Motor1Pin2 = 42;

//String 4
//QuadEncoder encoder(25, 23);
//const int Motor1Pin1 = 40;
//const int Motor1Pin2 = 38;

void setup()
{
  Serial.begin(BAUD_RATE);
  pinMode(Motor1Pin1, OUTPUT);   
  pinMode(Motor1Pin2, OUTPUT); 
  
  //Attach servos
  servo1.attach(servo1pin); 
  servo2.attach(servo2pin); 
  servo3.attach(servo3pin); 
  servo4.attach(servo4pin); 
  
  pinMode(bow_motorpin1, OUTPUT);   
  pinMode(bow_motorpin2, OUTPUT);
}

void MoveString(int ticksToMove)
{
  
  int pin1 = Motor1Pin1;
  int pin2 = Motor1Pin2;
  
  long failTime = 10000; // 10 seconds
  long failTimer = millis();
  int ticks = 0;
  while (ticks < abs(ticksToMove))
  {
    if (millis() - failTimer > failTime)
    {
      Serial.println("");
      Serial.println("Stalled trying to move the motor");
      HoldString(pin1, pin2);
      return;
    }
    
    if (ticksToMove > 0)
    {
      TightenString(pin1, pin2);  
    }
    else
    {
      LoosenString(pin1, pin2);   
    }
    
    int moved = encoder.tick();
    
    if (moved == '-'){
     //do nothing
    }else{
     ticks = moved;
    }
  }
  
  HoldString(pin1, pin2);
  Serial.print("Finished moving string ");
  Serial.print(ticksToMove);
  Serial.println(" ticks");
}
  

void LoosenString(int pin1, int pin2)
{
  digitalWrite(pin1, HIGH);
  digitalWrite(pin2, LOW);
}

void TightenString(int pin1, int pin2)
{
  digitalWrite(pin1, LOW);
  digitalWrite(pin2, HIGH);
}

void HoldString(int pin1, int pin2)
{
  digitalWrite(pin1, LOW);
  digitalWrite(pin2, LOW); 
}
  
void loop()
{
  
  //STOP BOW
  digitalWrite(bow_motorpin1, LOW);
  digitalWrite(bow_motorpin2, LOW); 
  
  //Push strings down
  servo1.write(35);
  servo2.write(40);
  servo3.write(50);
  servo4.write(50);
  
  if (Serial.available())
  {
    int index = 0;
    char message[4];
    
    // Erase what was previously in the buffer
    for (int i = 0; i < 4; i++)
    {
      message[i] = '\0';  
    }
    
    // Wait for the entire message to fill the buffer
    delay(100);
    
    // Read from the buffer
    while(Serial.available())
    {
      // Read the first 3 values in the buffer
      if (index < 3)
      {
        message[index] = Serial.read();
        index++;
      }
      // And truncate the rest of the values
      else
      {
        Serial.flush(); 
      }
    }
    // Move the string according to how many ticks message specifies
    Serial.println(atoi(message));
    MoveString(atoi(message));
  }
}
