kotoole1/LooneyTunes/MotorControl/H_Bridge_example/H_Bridge_example.ino

const int Motor1Pin1 = 8;
const int Motor1Pin2 = 9;
const int Motor2Pin1 = 10;
const int Motor2Pin2 = 11;

void setup() {                
  pinMode(Motor1Pin1, OUTPUT);   
  pinMode(Motor1Pin2, OUTPUT);   
  pinMode(Motor2Pin1, OUTPUT);   
  pinMode(Motor2Pin2, OUTPUT);     
}


void loop() {
  GoForward();
  delay(2000);
  GoBackward();
  delay(2000);
  GoRight();
  delay(2000);
  GoLeft();
  delay(2000);
  Stop();
  delay(2000);             
}

void GoForward(){
  digitalWrite(Motor1Pin2, LOW);
  digitalWrite(Motor1Pin1, HIGH);
  digitalWrite(Motor2Pin2, LOW);
  digitalWrite(Motor2Pin1, HIGH);
}

void GoBackward(){
  digitalWrite(Motor1Pin1, LOW);
  digitalWrite(Motor1Pin2, HIGH);
  digitalWrite(Motor2Pin1, LOW);
  digitalWrite(Motor2Pin2, HIGH);
}

void GoLeft(){
  digitalWrite(Motor1Pin1, LOW);
  digitalWrite(Motor1Pin2, HIGH);
  digitalWrite(Motor2Pin2, LOW);
  digitalWrite(Motor2Pin1, HIGH);
}

void GoRight(){
  digitalWrite(Motor1Pin2, LOW);
  digitalWrite(Motor1Pin1, HIGH);
  digitalWrite(Motor2Pin1, LOW);
  digitalWrite(Motor2Pin2, HIGH);
}

void Stop(){
  digitalWrite(Motor1Pin2, LOW);
  digitalWrite(Motor1Pin1, LOW);
  digitalWrite(Motor2Pin1, LOW);
  digitalWrite(Motor2Pin2, LOW);
}
