kotoole1/LooneyTunes/(commit log)

2013-10-19 Added encoder and motor control test code
2013-10-22 Added a navbar to the website and hooked up the motor to the encoder
2013-10-23 Fixed the motor control to stop with the encoder
    [Motor_brakes.ino]
2013-11-03 Freakin motors
2013-11-16 Found a SERVO_WRITE_FREQ that moves the servos an appreciable amount
2013-11-21 Started working on Encoder control; Made code modular/importable; Added a test class
2013-12-03 Pushing new test code and added a servo file
2013-12-03 Figured out the issue with the encoder. We can determine when the encoder moves 7.5 degrees, as opposed to 30 degrees. We need to rework QuadEncoder.js.
    [Test.js]
2013-12-04 Interrupt Handlers work
2013-12-07 Adding new Motor.js and Player.js files
2013-12-08 Deleted the old quad encoder code and added test cases for the motor, servo, and encoder
2013-12-10 adding pin numbers and fleshing out architecture
2013-12-13 adding Twinkle twinkle that is overshooting
    [Constants.js, Run_Bow.ino, Twinkle_FullSystem.ino, sketch_dec12a.ino, tuningBigEncoder.ino]
2013-12-15 changed servo numbers for runBow
2013-12-15 addign python code to make arduino's arrays for playing songs.
2013-12-16 ideal framework for scalable code
2013-12-17 added code samples images
2013-12-17 Added BoM.
2013-12-17 Fixed the header issue for mobile devices and fixed the image rendering issues
2013-12-18 adding full schematic and NOT spelling it wrong
